microfarad-de/toothbrush-timer/doc/toothbrush-timer-bom.html

Ref | Qnty | Value | Part | Datasheet | Description | Vendor
BT1 | 1 | CR2025 | Device:Battery_Cell | ~ | Single-cell battery
D1, D2 | 2 | 1N4151 | Device:D | ~ | Diode
D3, D4, D5, D6, D7, D8, D9, D10, D11 | 9 | LED | Device:LED | ~ | Light emitting diode
Q1 | 1 | IRLML2244 | Device:Q_PMOS_GDS | ~ | P-MOSFET transistor, gate/drain/source
Q2 | 1 | IRLML6244 | Device:Q_NMOS_GDS | ~ | N-MOSFET transistor, gate/drain/source
R1, R2 | 2 | 1M | Device:R | ~ | Resistor
R3 | 1 | 2K2 | Device:R | ~ | Resistor
SW1 | 1 | Power | Switch:SW_Push |  | Push button switch, generic, two pins
U1 | 1 | Arduino_Pro_Mini | microfarad-de:Arduino_Pro_Mini
