microfarad-de/toothbrush-timer/doc/toothbrush-timer-schematic.pdf

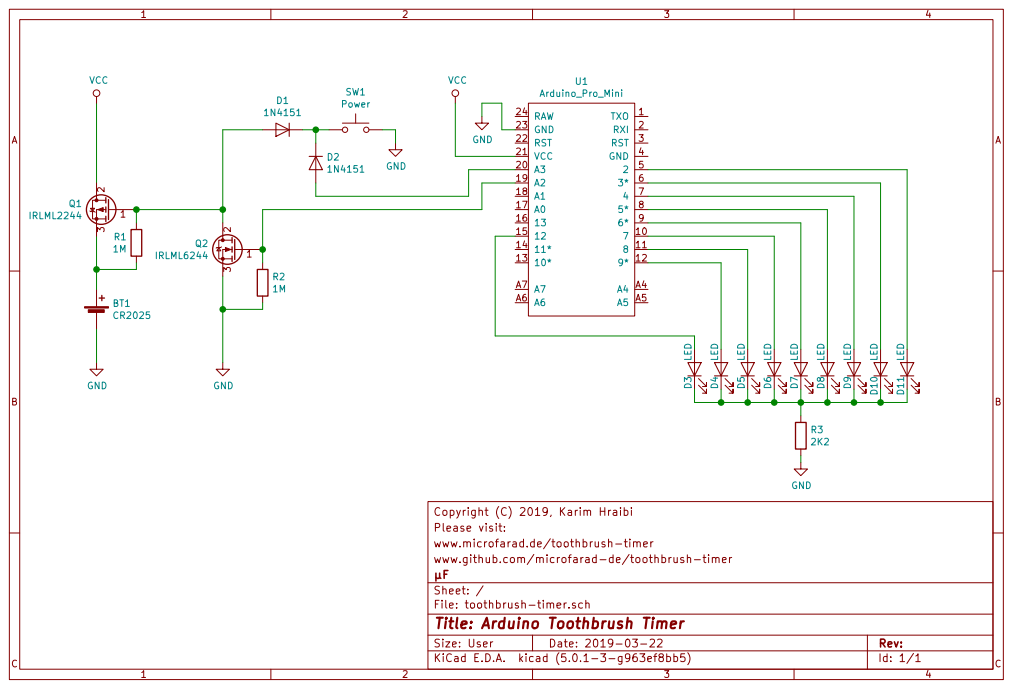
[picture p2: page 1]

www.github.com/microfarad-de/toothbrush-timer www.microfarad.de/toothbrush-timer Please visit: Copyright (C) 2019, Karim Hraibi

Id: 1/1 Title: Arduino Toothbrush Timer File: toothbrush-timer.sch Sheet: / µF
