microfarad-de/toothbrush-timer/(threads)

Thread 1 (2020-05-17):

Is it possible that the P and N MOSFET are mixed up (in schematic description)?

synth3, 2020-05-17:
Hi there,

first of all: Thanks for sharing this project! :)

Is there a possibility that the p and the n MOSFET are mixed up in the schematic and description?

> Briefly pressing SW1 would connect the gate of the MOSFET Q1 to the power supply ground through D1, this will cause the N-channel MOSFT Q1 to turn on and connect the positive battery terminal to the VCC rail.

I thought P-MOSFETs need a low gate voltage to turn on (not N)?

...Maybe I don't fully understand your circuit, but I wasn't able to simulate the expected behavior with the circuit as shown - after changing the P and N MOSFETs it worked...
