microfarad-de/toothbrush-timer/(commit log)

2019-02-16 Configured power save mode
2019-02-17 Set the correct sleep mode
    [brush-timer.ino]
2019-02-19 Full countdown timer
2019-02-20 Enable watchdog timer
2019-02-21 Improved random generator
    Updated comments and schematic
2019-02-22 Misc. improvments
    - Create new animation
    - Prevent same animation to repeate two consecutive times
    - Animations are run to completion
    [brush-timer.ino]
2019-02-26 Updated pictures and circuit diagram
2019-02-27 Disable ADC trhough ADCSRA register
    Use ADCSRA &= ~(1 << ADEN); to properly disable the ADC,
    this reduces the Power-Down sleep mode power consumption
    from 100µA to 10µA.
2019-03-12 Reorder commands for disabling the ADC
2019-06-20 Romove power on delay, improve animation selection
